AdarshGouda/RUDRAv1/Rudrav1_description/meshes/motor.STL

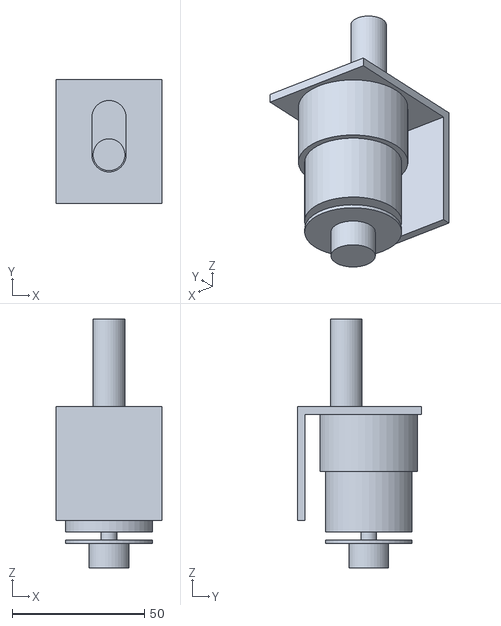
[picture p12: CAD file, 2021-05-02]
Rudrav1_description/meshes/motor.STL
40.0 x 47.0 x 94.0
