AdarshGouda/RUDRAv1/Rudrav1_description/meshes/kinect_sensor.stl

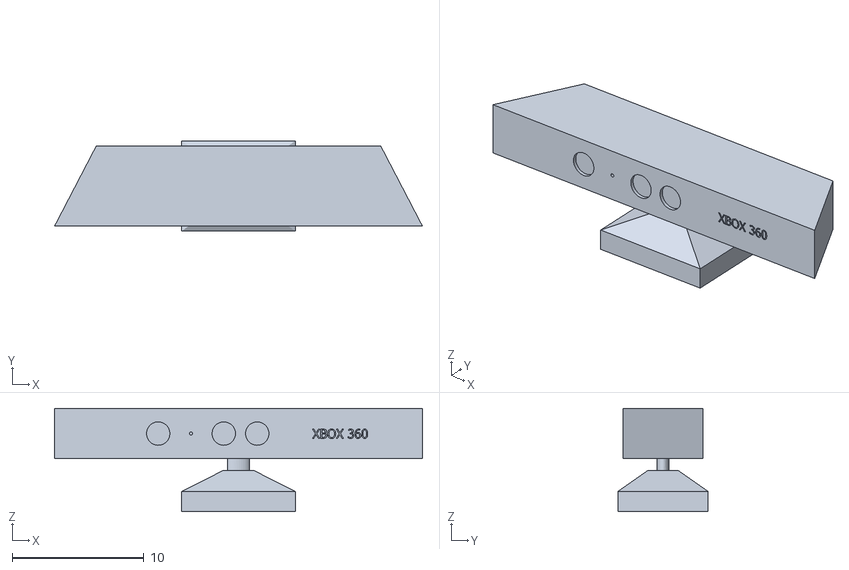
[picture p13: CAD file, 2021-05-02]
Rudrav1_description/meshes/kinect_sensor.stl
27.9 x 6.86 x 7.82
