AdarshGouda/RUDRAv1/Rudrav1_description/meshes/wheel.STL

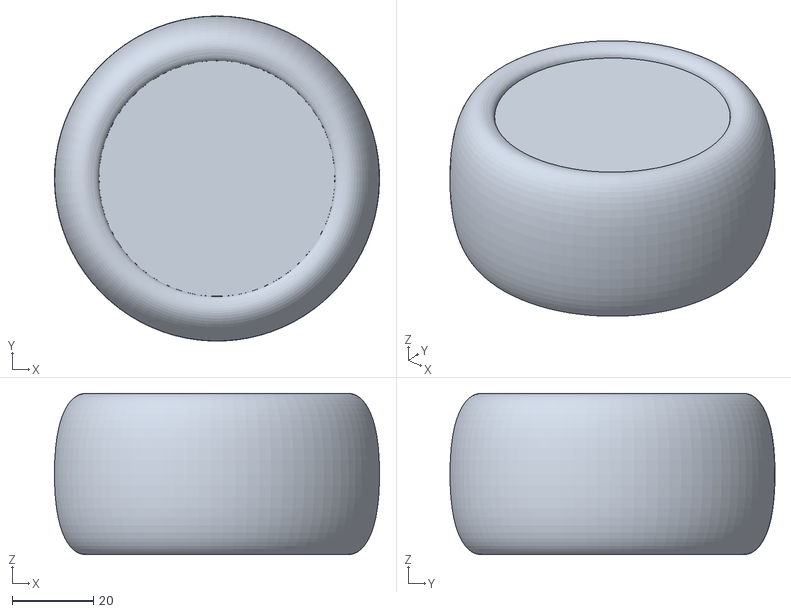
[picture p14: CAD file, 2021-05-02]
Rudrav1_description/meshes/wheel.STL
80.0 x 80.0 x 39.6
