AdarshGouda/RUDRAv1/Rudrav1_description/meshes/base.STL

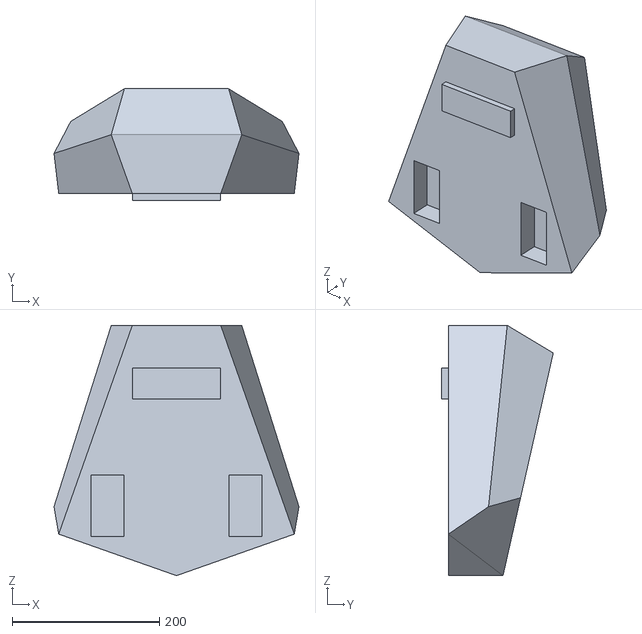
[picture p15: CAD file, 2021-05-02]
Rudrav1_description/meshes/base.STL
332.8 x 151.5 x 340.0
