AdarshGouda/RUDRAv1/Rudrav1_description/meshes/support_wheel.STL

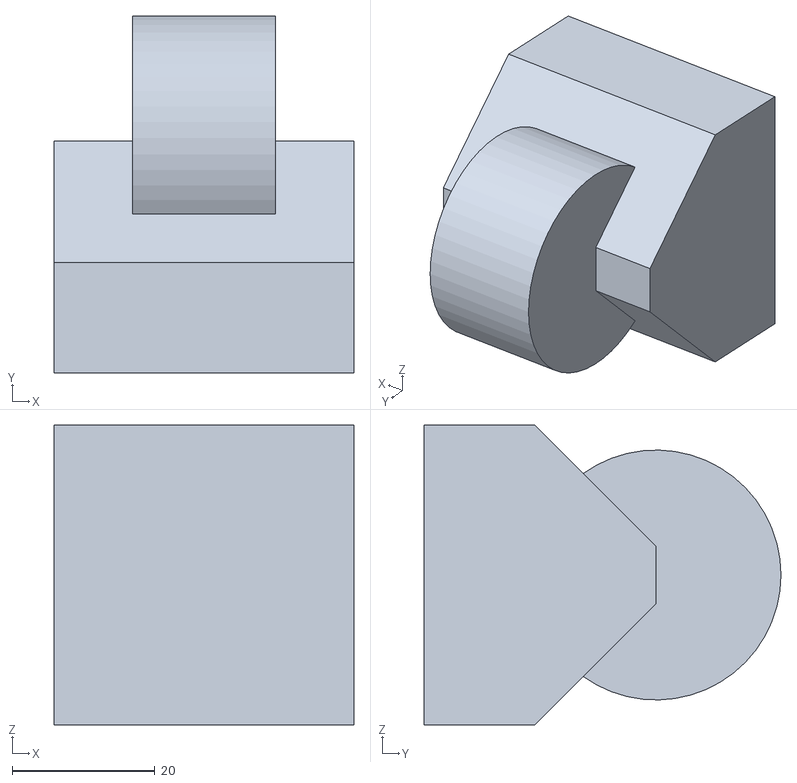
[picture p16: CAD file, 2021-05-02]
Rudrav1_description/meshes/support_wheel.STL
42.0 x 50.0 x 42.0
